bartoszp1992/eclipse/doc/pcb/lightring1/lightring.png

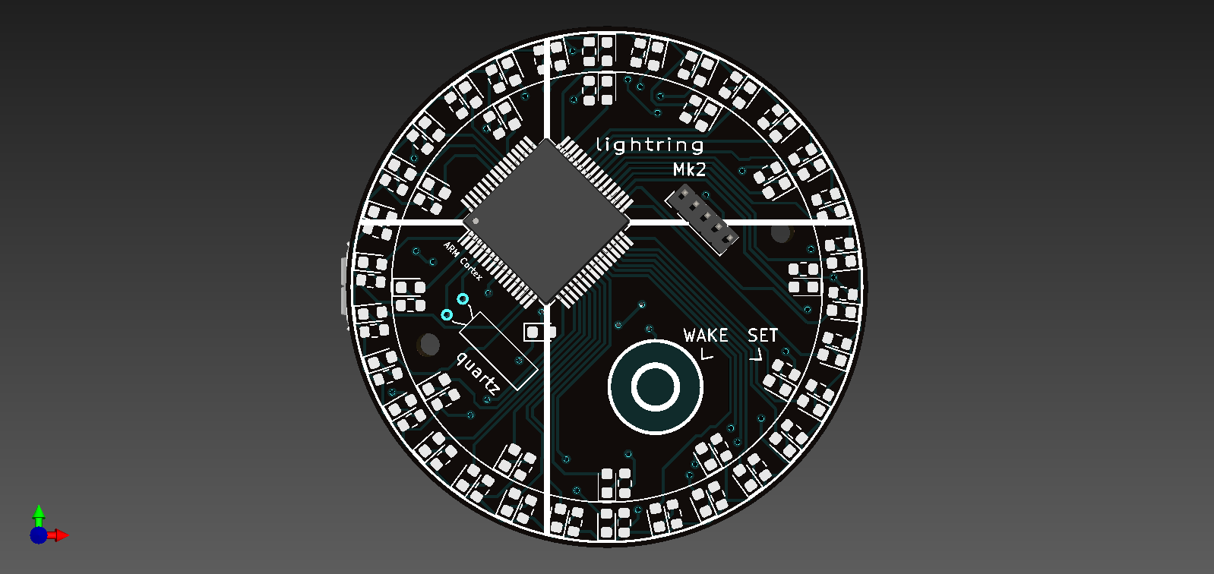
doc/pcb/lightring1/lightring.png
