bartoszp1992/eclipse/doc/pcb/lightring1/output/lightring.pdf

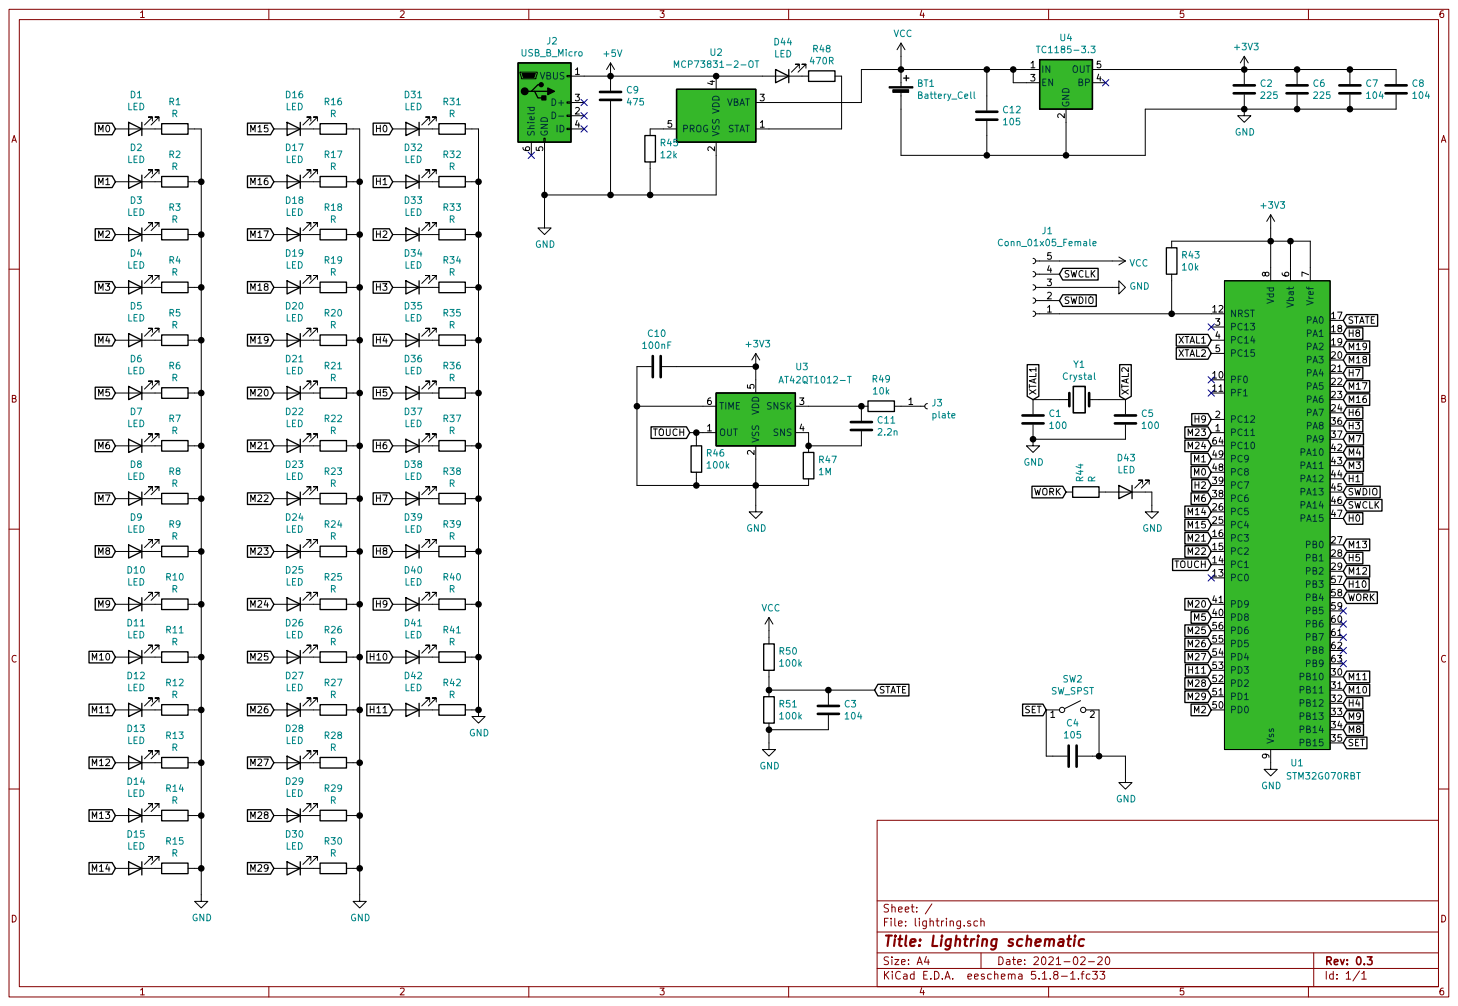
[picture p2: page 1]

File: lightring.sch Sheet: / D12
LED

Id: 1/1 Title: Lightring schematic
