bartoszp1992/eclipse/doc/pcb/lightring1/lightring.kicad_pcb

## KiCad design doc/pcb/lightring1/lightring.kicad_pcb (2021-02-03)

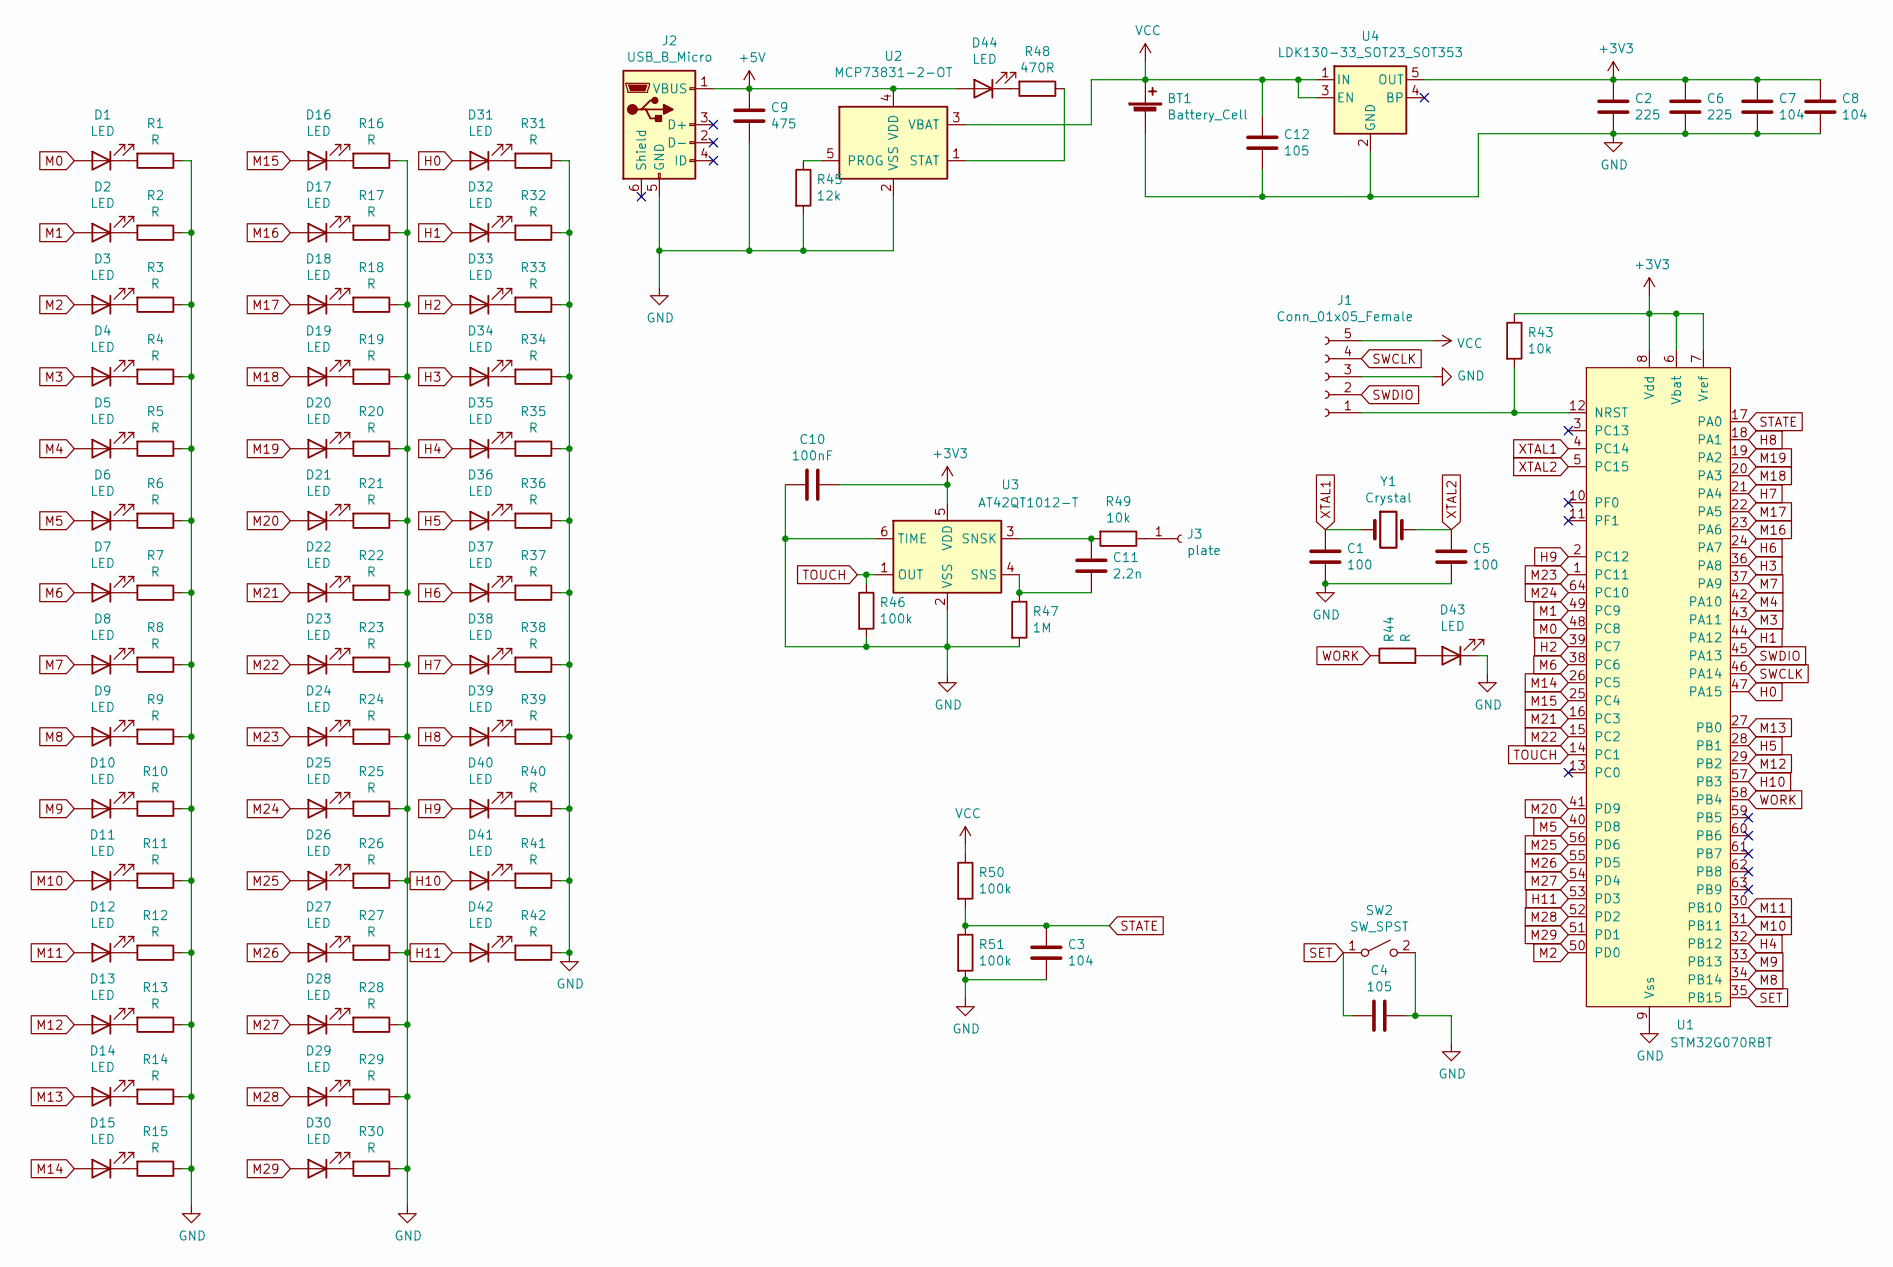
[picture p3: schematic lightring.sch]

Parts:
BT1: Battery_Cell; R_1210_3225Metric
C1, C5: 100; C_0603_1608Metric
C2, C6: 225; C_0603_1608Metric
C3, C7, C8: 104; C_0603_1608Metric
C4, C12: 105; C_0603_1608Metric
C9: 475; C_0603_1608Metric
C10: 100nF; C_0603_1608Metric
C11: 2.2n; C_0603_1608Metric
D1, D2, D3, D4, D5, D6, D7, D8, D9, D10, D11, D12, D13, D14, D15, D16, D17, D18, D19, D20, D21, D22, D23, D24, D25, D26, D27, D28, D29, D30, D31, D32, D33, D34, D35, D36, D37, D38, D39, D40, D41, D42, D43: LED; LR_LED
D44: LED; D_0603_1608Metric
J1: Conn_01x05_Female; PinHeader_1x05_P1.27mm_Vertical
J2: USB_B_Micro; USB_Micro-B_Molex_47346-0001
J3: plate; touchplate
R1, R2, R3, R4, R5, R6, R7, R8, R9, R10, R11, R12, R13, R14, R15, R16, R17, R18, R19, R20, R21, R22, R23, R24, R25, R26, R27, R28, R29, R30, R31, R32, R33, R34, R35, R36, R37, R38, R39, R40, R41, R42: R; LR_RES
R43, R49: 10k; R_0603_1608Metric
R44: R; R_0603_1608Metric
R45: 12k; R_0603_1608Metric
R46, R50, R51: 100k; R_0603_1608Metric
R47: 1M; R_0603_1608Metric
R48: 470R; R_0603_1608Metric
SW2: SW_SPST; Panasonic_EVQPUJ_EVQPUA
U1: STM32G070RBT; LQFP-64_10x10mm_P0.5mm
U2: MCP73831-2-OT; SOT-23-5
U3: AT42QT1012-T; SOT-23-6
U4: LDK130-33_SOT23_SOT353; SOT-23-5
Y1: Crystal; Crystal_C26-LF_D2.1mm_L6.5mm_Horizontal

Connections:
+3V3: C2.1, C6.1, C7.1, C8.1, C10.1, R43.1, U1.6 (Vbat), U1.7 (Vref), U1.8 (Vdd), U3.5 (VDD), U4.5 (OUT)
+5V: C9.1, D44.2 (A), J2.1 (VBUS), U2.4 (VDD)
GND: BT1.2 (-), C1.2, C2.2, C3.2, C4.1, C5.2, C6.2, C7.2, C8.2, C9.2, C10.2, C12.2, D43.1 (K), J1.3, J2.5 (GND), R1.1, R2.1, R3.1, R4.1, R5.1, R6.1, R7.1, R8.1, R9.1, R10.1, R11.1, R12.1, R13.1, R14.1, R15.1, R16.1, R17.1, R18.1, R19.1, R20.1, R21.1, R22.1, R23.1, R24.1, R25.1, R26.1, R27.1, R28.1, R29.1, R30.1, R31.1, R32.1, R33.1, R34.1, R35.1, R36.1, R37.1, R38.1, R39.1, R40.1, R41.1, R42.1, R45.2, R46.2, R47.2, R51.2, SW2.2 (B), U1.9 (Vss), U2.2 (VSS), U3.2 (VSS), U3.6 (TIME), U4.2 (GND)
H0: D31.2 (A), U1.47 (PA15)
H1: D32.2 (A), U1.44 (PA12)
H2: D33.2 (A), U1.39 (PC7)
H3: D34.2 (A), U1.36 (PA8)
H4: D35.2 (A), U1.32 (PB12)
H5: D36.2 (A), U1.28 (PB1)
H6: D37.2 (A), U1.24 (PA7)
H7: D38.2 (A), U1.21 (PA4)
H8: D39.2 (A), U1.18 (PA1)
H9: D40.2 (A), U1.2 (PC12)
H10: D41.2 (A), U1.57 (PB3)
H11: D42.2 (A), U1.53 (PD3)
M0: D1.2 (A), U1.48 (PC8)
M1: D2.2 (A), U1.49 (PC9)
M2: D3.2 (A), U1.50 (PD0)
M3: D4.2 (A), U1.43 (PA11)
M4: D5.2 (A), U1.42 (PA10)
M5: D6.2 (A), U1.40 (PD8)
M6: D7.2 (A), U1.38 (PC6)
M7: D8.2 (A), U1.37 (PA9)
M8: D9.2 (A), U1.34 (PB14)
M9: D10.2 (A), U1.33 (PB13)
M10: D11.2 (A), U1.31 (PB11)
M11: D12.2 (A), U1.30 (PB10)
M12: D13.2 (A), U1.29 (PB2)
M13: D14.2 (A), U1.27 (PB0)
M14: D15.2 (A), U1.26 (PC5)
M15: D16.2 (A), U1.25 (PC4)
M16: D17.2 (A), U1.23 (PA6)
M17: D18.2 (A), U1.22 (PA5)
M18: D19.2 (A), U1.20 (PA3)
M19: D20.2 (A), U1.19 (PA2)
M20: D21.2 (A), U1.41 (PD9)
M21: D22.2 (A), U1.16 (PC3)
M22: D23.2 (A), U1.15 (PC2)
M23: D24.2 (A), U1.1 (PC11)
M24: D25.2 (A), U1.64 (PC10)
M25: D26.2 (A), U1.56 (PD6)
M26: D27.2 (A), U1.55 (PD5)
M27: D28.2 (A), U1.54 (PD4)
M28: D29.2 (A), U1.52 (PD2)
M29: D30.2 (A), U1.51 (PD1)
unnamed: C11.1, R49.2, U3.3 (SNSK)
unnamed: C11.2, R47.1, U3.4 (SNS)
unnamed: D1.1 (K), R1.2
unnamed: D2.1 (K), R2.2
unnamed: D3.1 (K), R3.2
unnamed: D4.1 (K), R4.2
unnamed: D5.1 (K), R5.2
unnamed: D6.1 (K), R6.2
unnamed: D7.1 (K), R7.2
unnamed: D8.1 (K), R8.2
unnamed: D9.1 (K), R9.2
unnamed: D10.1 (K), R10.2
unnamed: D11.1 (K), R11.2
unnamed: D12.1 (K), R12.2
unnamed: D13.1 (K), R13.2
unnamed: D14.1 (K), R14.2
unnamed: D15.1 (K), R15.2
unnamed: D16.1 (K), R16.2
unnamed: D17.1 (K), R17.2
unnamed: D18.1 (K), R18.2
unnamed: D19.1 (K), R19.2
unnamed: D20.1 (K), R20.2
unnamed: D21.1 (K), R21.2
unnamed: D22.1 (K), R22.2
unnamed: D23.1 (K), R23.2
unnamed: D24.1 (K), R24.2
unnamed: D25.1 (K), R25.2
unnamed: D26.1 (K), R26.2
unnamed: D27.1 (K), R27.2
unnamed: D28.1 (K), R28.2
unnamed: D29.1 (K), R29.2
unnamed: D30.1 (K), R30.2
unnamed: D31.1 (K), R31.2
unnamed: D32.1 (K), R32.2
unnamed: D33.1 (K), R33.2
unnamed: D34.1 (K), R34.2
unnamed: D35.1 (K), R35.2
unnamed: D36.1 (K), R36.2
unnamed: D37.1 (K), R37.2
unnamed: D38.1 (K), R38.2
unnamed: D39.1 (K), R39.2
unnamed: D40.1 (K), R40.2
unnamed: D41.1 (K), R41.2
unnamed: D42.1 (K), R42.2
unnamed: D43.2 (A), R44.2
unnamed: D44.1 (K), R48.2
unnamed: J1.1, R43.2, U1.12 (NRST)
unnamed: J3.1, R49.1
unnamed: R45.1, U2.5 (PROG)
unnamed: R48.1, U2.1 (STAT)
SET: C4.2, SW2.1 (A), U1.35 (PB15)
STATE: C3.1, R50.2, R51.1, U1.17 (PA0)
SWCLK: J1.4, U1.46 (PA14)
SWDIO: J1.2, U1.45 (PA13)
TOUCH: R46.1, U1.14 (PC1), U3.1 (OUT)
VCC: BT1.1 (+), C12.1, J1.5, R50.1, U2.3 (VBAT), U4.1 (IN), U4.3 (EN)
WORK: R44.1, U1.58 (PB4)
XTAL1: C1.1, U1.4 (PC14), Y1.1
XTAL2: C5.1, U1.5 (PC15), Y1.2

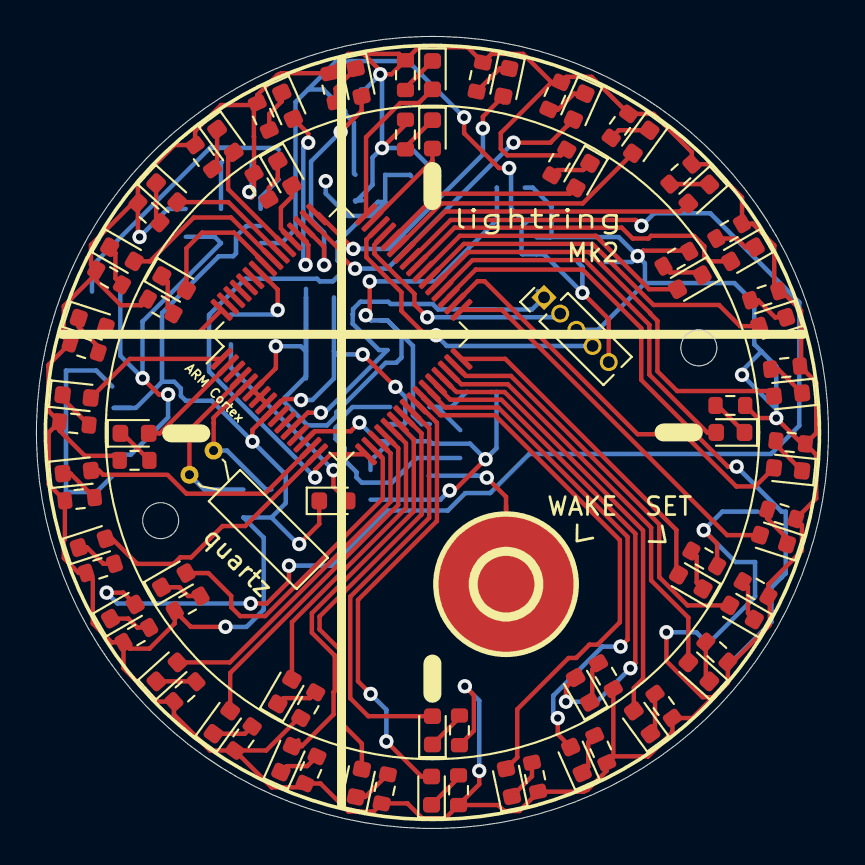
[picture p4: board lightring.kicad_pcb from above]

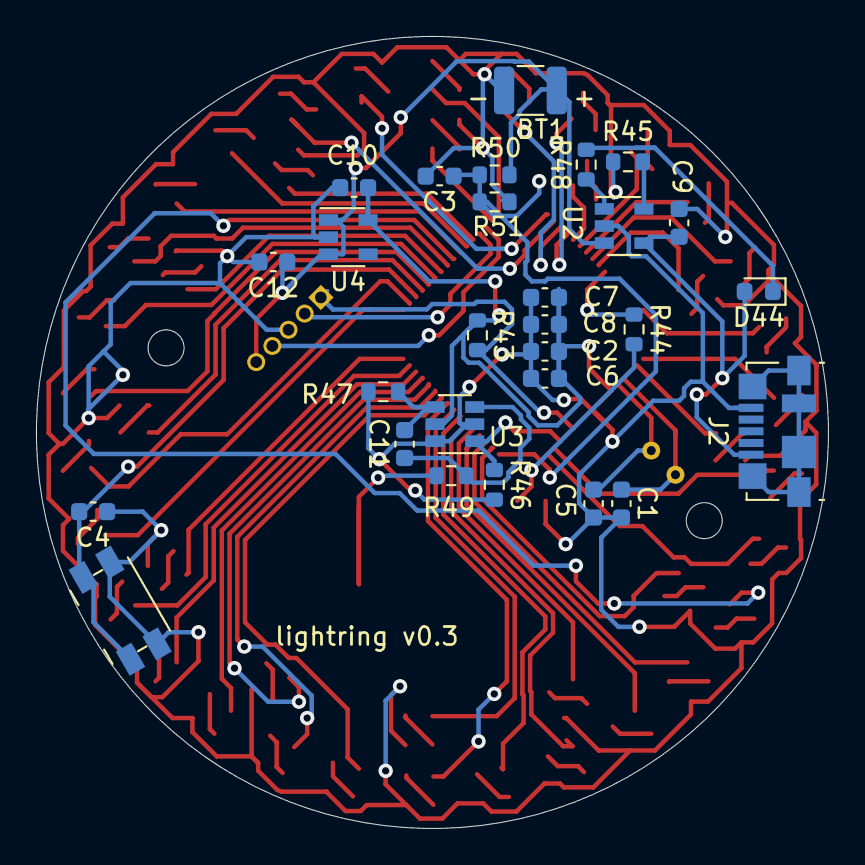
[picture p5: board lightring.kicad_pcb from below]

Board: 2 copper layers, 44.0 x 44.0 mm, 117 parts (28 on the bottom side), 104 nets.
