bartoszp1992/eclipse/Core/Src/main.c

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
/* Includes ------------------------------------------------------------------*/
#include "main.h"

/* USER CODE BEGIN Includes */
#include "../display/display.h"
#include "../interrupts/interrupts.h"
#include "../rtc/rtc.h"
/* USER CODE END Includes */

ADC_HandleTypeDef hadc1;

RTC_HandleTypeDef hrtc;

void SystemClock_Config(void);
static void MX_GPIO_Init(void);
static void MX_RTC_Init(void);
static void MX_ADC1_Init(void);
/**
  * @brief  The application entry point.
  * @retval int
  */
int main(void)
{
  /* MCU Configuration--------------------------------------------------------*/

  /* Reset of all peripherals, Initializes the Flash interface and the Systick. */
  HAL_Init();

  /* Configure the system clock */
  SystemClock_Config();

  /* Initialize all configured peripherals */
  MX_GPIO_Init();
  MX_RTC_Init();
  MX_ADC1_Init();
  /* USER CODE BEGIN 2 */
	mode = MODE_NORMAL;
	dontSleepFlag = 0;
  /* USER CODE END 2 */

  /* Infinite loop */
  /* USER CODE BEGIN WHILE */
	while (1) {

		if (mode == MODE_NORMAL) {

			rtcGetTime();
			displayShowTime(hours, minutes, 20, 15);
			dontSleepFlag = 0;

		} else if (mode == MODE_SETTINGS_H || mode == MODE_SETTINGS_M) {

			displayTurnOff();
			displayTurnMinutesLED(minutes / 2, 1);

			if (minutes % 2 == 1) {

				HAL_GPIO_WritePin(WORK_GPIO_Port, WORK_Pin, 1);

			} else {

				HAL_GPIO_WritePin(WORK_GPIO_Port, WORK_Pin, 0);

			}

			displayTurnHoursLED(hours, 1);
			HAL_Delay(50);

		} else if (mode == MODE_SETTINGS_S) {

			rtcGetTime();
			displayTurnOff();
			displayTurnMinutesLED(seconds / 2, 1);

			if (seconds % 2 == 1) {

				HAL_GPIO_WritePin(WORK_GPIO_Port, WORK_Pin, 1);

			} else {

				HAL_GPIO_WritePin(WORK_GPIO_Port, WORK_Pin, 0);

			}

			HAL_Delay(50);

		} else if (mode == MODE_SLEEP) {

			HAL_GPIO_WritePin(WORK_GPIO_Port, WORK_Pin, 1);
			HAL_Delay(50);
			HAL_GPIO_WritePin(WORK_GPIO_Port, WORK_Pin, 0);

		} else if(mode == MODE_FORCE){

			rtcGetTime();//for actual seconds reading

			if(HAL_GPIO_ReadPin(SET_GPIO_Port, SET_Pin) == 1){
				displayShowTimeForce(hours, minutes, 0);
			}else{
				displayShowTimeForce(0, seconds, 1);
			}


		}

		if ((mode == MODE_NORMAL || mode == MODE_SLEEP) && dontSleepFlag == 0) {

			mode = MODE_SLEEP;
			HAL_PWR_EnterSTOPMode(PWR_LOWPOWERREGULATOR_ON, PWR_STOPENTRY_WFI);

		}

    /* USER CODE END WHILE */

    /* USER CODE BEGIN 3 */
	}
  /* USER CODE END 3 */
}

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
