bartoszp1992/eclipse/Core/Inc/main.h

#define M23_Pin GPIO_PIN_11
#define M23_GPIO_Port GPIOC
#define H9_Pin GPIO_PIN_12
#define H9_GPIO_Port GPIOC
#define TOUCH_Pin GPIO_PIN_1
#define TOUCH_GPIO_Port GPIOC
#define TOUCH_EXTI_IRQn EXTI0_1_IRQn
#define M22_Pin GPIO_PIN_2
#define M22_GPIO_Port GPIOC
#define M21_Pin GPIO_PIN_3
#define M21_GPIO_Port GPIOC
#define STATE_Pin GPIO_PIN_0
#define STATE_GPIO_Port GPIOA
#define H8_Pin GPIO_PIN_1
#define H8_GPIO_Port GPIOA
#define M19_Pin GPIO_PIN_2
#define M19_GPIO_Port GPIOA
#define M18_Pin GPIO_PIN_3
#define M18_GPIO_Port GPIOA
#define H7_Pin GPIO_PIN_4
#define H7_GPIO_Port GPIOA
#define M17_Pin GPIO_PIN_5
#define M17_GPIO_Port GPIOA
#define M16_Pin GPIO_PIN_6
#define M16_GPIO_Port GPIOA
#define H6_Pin GPIO_PIN_7
#define H6_GPIO_Port GPIOA
#define M15_Pin GPIO_PIN_4
#define M15_GPIO_Port GPIOC
#define M14_Pin GPIO_PIN_5
#define M14_GPIO_Port GPIOC
#define M13_Pin GPIO_PIN_0
#define M13_GPIO_Port GPIOB
#define H5_Pin GPIO_PIN_1
#define H5_GPIO_Port GPIOB
#define M12_Pin GPIO_PIN_2
#define M12_GPIO_Port GPIOB
#define M11_Pin GPIO_PIN_10
#define M11_GPIO_Port GPIOB
#define M10_Pin GPIO_PIN_11
#define M10_GPIO_Port GPIOB
#define H4_Pin GPIO_PIN_12
#define H4_GPIO_Port GPIOB
#define M9_Pin GPIO_PIN_13
#define M9_GPIO_Port GPIOB
#define M8_Pin GPIO_PIN_14
#define M8_GPIO_Port GPIOB
#define SET_Pin GPIO_PIN_15
#define SET_GPIO_Port GPIOB
#define SET_EXTI_IRQn EXTI4_15_IRQn
#define H3_Pin GPIO_PIN_8
#define H3_GPIO_Port GPIOA
#define M7_Pin GPIO_PIN_9
#define M7_GPIO_Port GPIOA
#define M6_Pin GPIO_PIN_6
#define M6_GPIO_Port GPIOC
#define H2_Pin GPIO_PIN_7
#define H2_GPIO_Port GPIOC
#define M5_Pin GPIO_PIN_8
#define M5_GPIO_Port GPIOD
#define M20_Pin GPIO_PIN_9
#define M20_GPIO_Port GPIOD
#define M4_Pin GPIO_PIN_10
#define M4_GPIO_Port GPIOA
#define M3_Pin GPIO_PIN_11
#define M3_GPIO_Port GPIOA
#define H1_Pin GPIO_PIN_12
#define H1_GPIO_Port GPIOA
#define H0_Pin GPIO_PIN_15
#define H0_GPIO_Port GPIOA
#define M0_Pin GPIO_PIN_8
#define M0_GPIO_Port GPIOC
#define M1_Pin GPIO_PIN_9
#define M1_GPIO_Port GPIOC
#define M2_Pin GPIO_PIN_0
#define M2_GPIO_Port GPIOD
#define M29_Pin GPIO_PIN_1
#define M29_GPIO_Port GPIOD
#define M28_Pin GPIO_PIN_2
#define M28_GPIO_Port GPIOD
#define H11_Pin GPIO_PIN_3
#define H11_GPIO_Port GPIOD
#define M27_Pin GPIO_PIN_4
#define M27_GPIO_Port GPIOD
#define M26_Pin GPIO_PIN_5
#define M26_GPIO_Port GPIOD
#define M25_Pin GPIO_PIN_6
#define M25_GPIO_Port GPIOD
#define H10_Pin GPIO_PIN_3
#define H10_GPIO_Port GPIOB
#define WORK_Pin GPIO_PIN_4
#define WORK_GPIO_Port GPIOB
#define M24_Pin GPIO_PIN_10
#define M24_GPIO_Port GPIOC
#define MODE_NORMAL 0
#define MODE_SETTINGS_H 1
#define MODE_SETTINGS_M 2
#define MODE_SETTINGS_S 3
#define MODE_SLEEP 4
#define MODE_FORCE 5
