bartoszp1992/eclipse/Core/interrupts/interrupts.h

/*
 * interrupts.h
 *
 *  Created on: Jan 19, 2021
 *      Author: bartosz
 */

#ifndef INTERRUPTS_INTERRUPTS_H_
#define INTERRUPTS_INTERRUPTS_H_

#include "main.h"
#include "../display/display.h"

void extiCallback(uint16_t pin);

#endif /* INTERRUPTS_INTERRUPTS_H_ */
