bartoszp1992/eclipse/(commit log)

2020-12-05 finished PCB
    [base.kicad_pcb, lightring.kicad_pcb, lightring.sch]
2020-12-20 v2 base board
    [base-B_Cu.gbr, base-B_Mask.gbr, base-B_Paste.gbr, base-B_SilkS.gbr, base-Edge_Cuts.gbr, base-F_Cu.gbr, base-F_Mask.gbr, base-F_Paste.gbr]
2020-12-25 v0.2 board
    [lightring-B_Cu.gbr, lightring-B_Mask.gbr, lightring-B_Paste.gbr, lightring-B_SilkS.gbr, lightring-Edge_Cuts.gbr, lightring-F_Cu.gbr, lightring-F_Mask.gbr, lightring-F_Paste.gbr]
2021-01-19 testing program
    [lightring.sch]
2021-01-20 initial program
    [lightring.kicad_pcb, lightring.sch]
2021-01-21 working program
    [lightring.sch]
2021-01-21 silks corrections
    [lightring.kicad_pcb]
2021-01-21 working seconds and forcce mode
    [lightring.kicad_pcb]
2021-01-24 v0.3 PCB
    [lightring.kicad_pcb, lightring.sch]
2021-02-03 generated gerbers
    [lightring-B_Cu.gbr, lightring-B_Mask.gbr, lightring-B_Paste.gbr, lightring-B_SilkS.gbr, lightring-Edge_Cuts.gbr, lightring-F_Cu.gbr, lightring-F_Mask.gbr, lightring-F_Paste.gbr]
2021-02-18 removed old pcb
    [lightring.kicad_pcb, lightring.sch]
2021-02-18 changed stabiliser
    [lightring.sch]
2021-02-18 changed to mk2 in base
    [base.kicad_pcb]
2021-02-20 exported schematic
    [lightring.sch]
2021-06-08 added charger datasheet
